allhandsactive/door-controller/docs/NodeMCUv3_Pinout.png

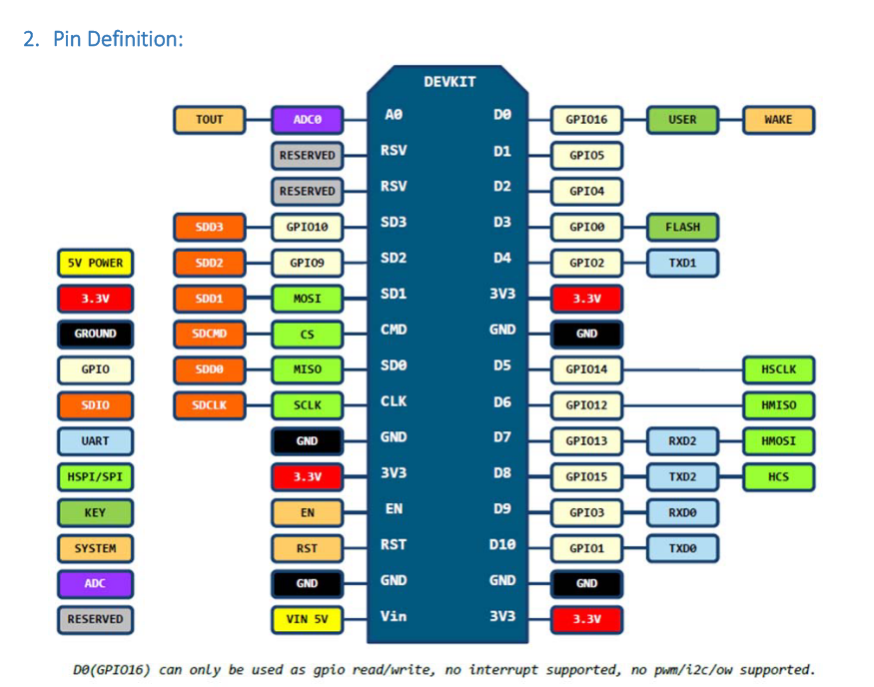
docs/NodeMCUv3_Pinout.png
