allhandsactive/door-controller/README.md

# door-controller
Code + PCB for ESP-based RFID card access door control
