allhandsactive/door-controller/pcb/pcb.kicad_pcb

## KiCad design pcb/pcb.kicad_pcb (2022-08-01)

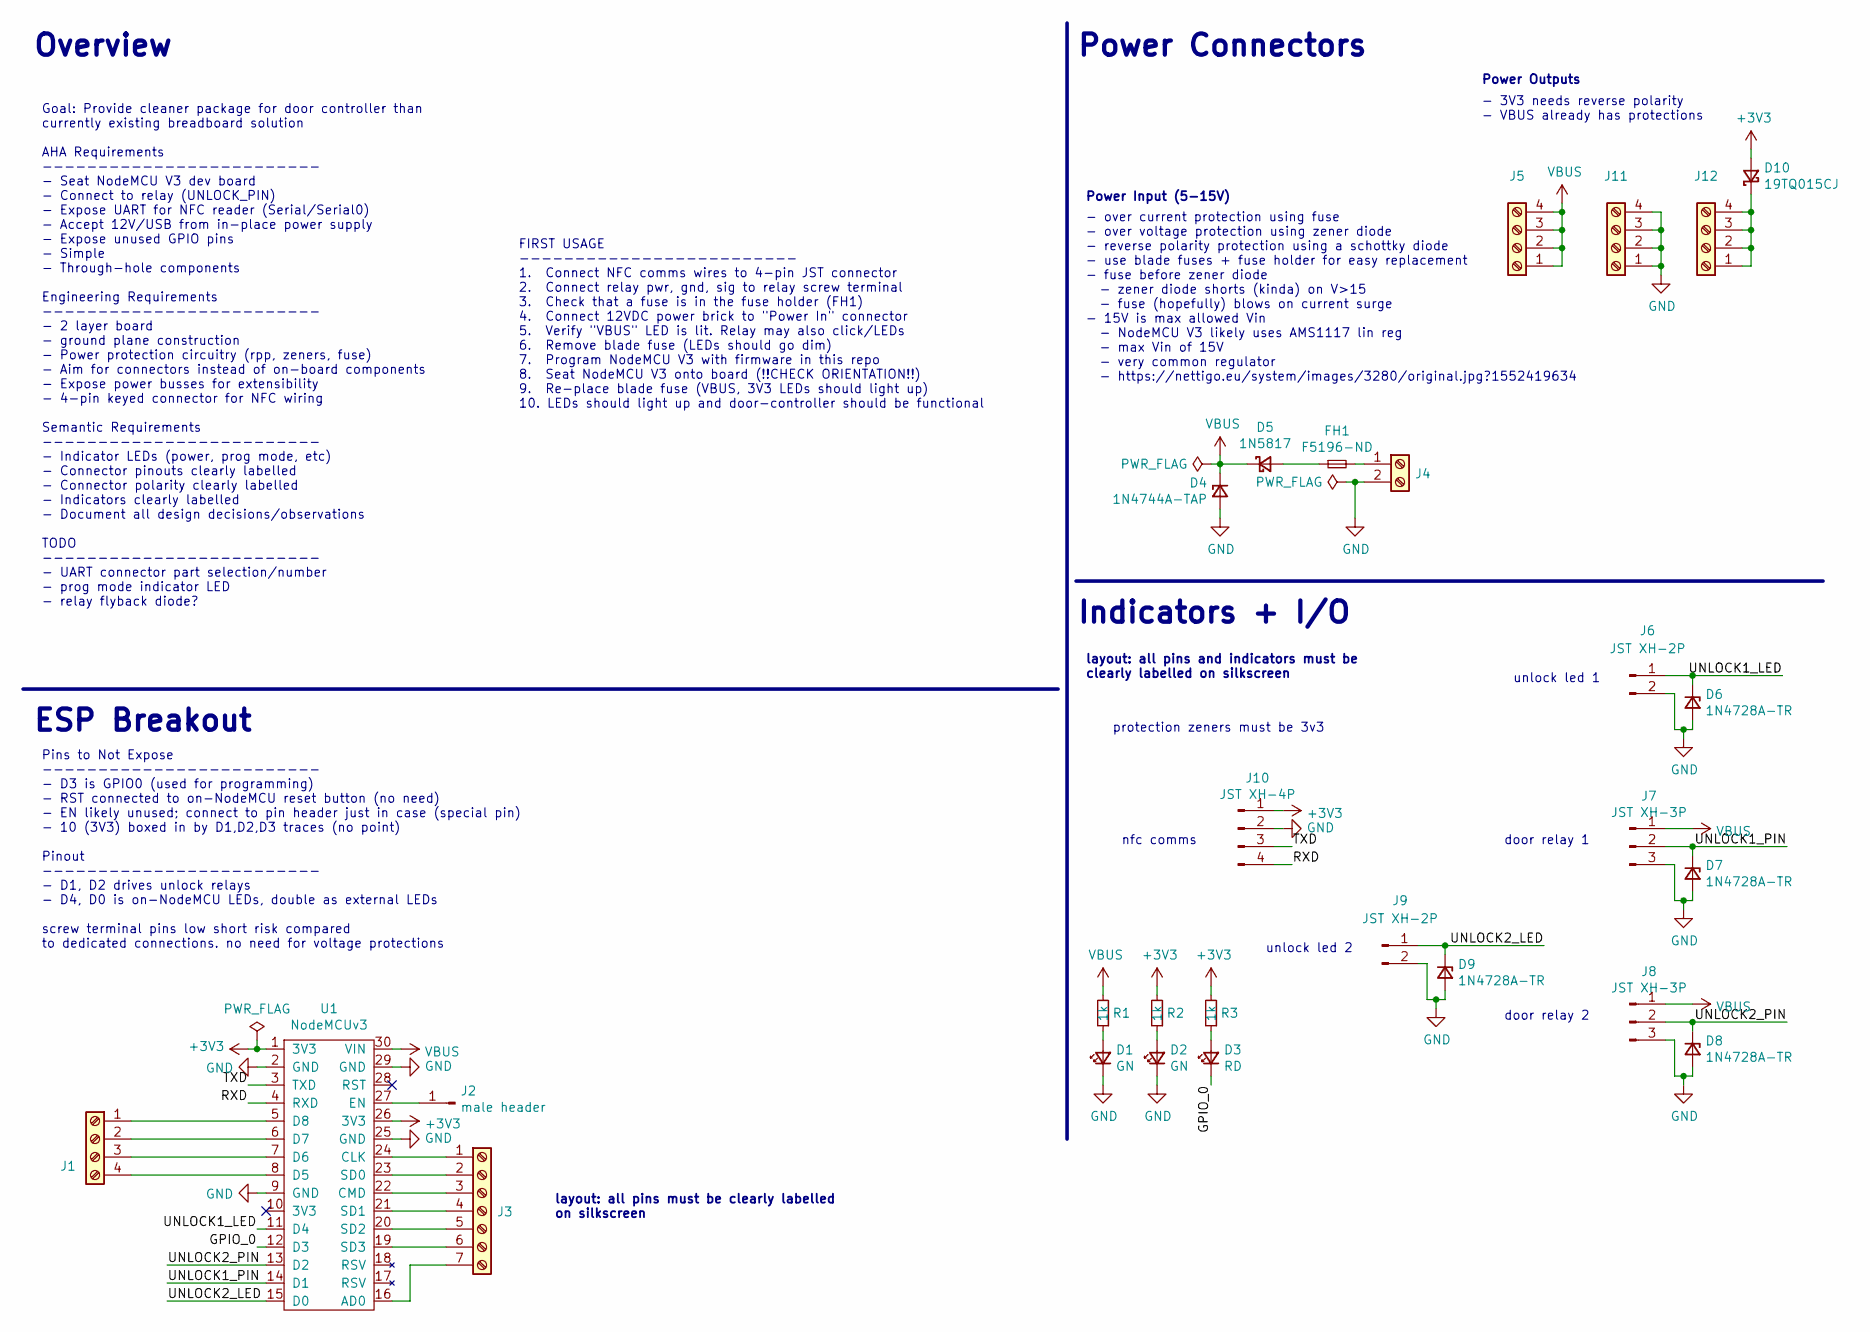
[picture p2: schematic pcb.kicad_sch, Door Controller]

Parts:
D1, D2: GN; LED_D5.0mm; PartNo LTL-4233; Digi-Key 160-1130-ND
D3: RD; LED_D5.0mm; PartNo LTL-4263; Digi-Key 160-1964-ND
D4: 1N4744A-TAP; D_DO-41_SOD81_P10.16mm_Horizontal; PartNo 1N4744A-TAP; Digi-Key 1N4744A-TAPGICT-ND
D5: 1N5817; D_DO-41_SOD81_P10.16mm_Horizontal; PartNo 1N5817-E3/54; Digi-Key 1N5817-E3/54GICT-ND
D6, D7, D8, D9: 1N4728A-TR; D_DO-41_SOD81_P10.16mm_Horizontal; PartNo 1N4728A-TR; Digi-Key 1N4728AVSCT-ND
D10: 19TQ015CJ; TO-220-2_Vertical; PartNo 19TQ015CJ; Digi-Key 1655-1005-ND
FH1: F5196-ND; Blade Fuse Holder; PartNo 178.6164.0002; Digi-Key F5196-ND
J1: Screw_Terminal_01x06; TerminalBlock_Phoenix_MPT-0,5-4-2.54_1x04_P2.54mm_Horizontal; PartNo 1725672; Digi-Key 277-1275-ND
J2: male header; PinHeader_1x01_P2.54mm_Vertical; PartNo 951101-8622-AR; Digi-Key 3M156413-01-ND
J3: Screw_Terminal_01x07; TerminalBlock_Phoenix_MPT-0,5-7-2.54_1x07_P2.54mm_Horizontal; PartNo 1725708; Digi-Key 277-1278-ND
J4: Screw_Terminal_01x02; TerminalBlock_Phoenix_MPT-0,5-2-2.54_1x02_P2.54mm_Horizontal; PartNo 1725656; Digi-Key 277-1273-ND
J5, J11, J12: Screw_Terminal_01x04; TerminalBlock_Phoenix_MPT-0,5-4-2.54_1x04_P2.54mm_Horizontal; PartNo 1725672; Digi-Key 277-1275-ND
J6, J9: JST XH-2P; JST_XH_B2B-XH-AM_1x02_P2.50mm_Vertical; PartNo B2B-XH-A-GU; Digi-Key 455-2946-ND
J7, J8: JST XH-3P; JST_XH_B3B-XH-AM_1x03_P2.50mm_Vertical; PartNo B3B-XH-AM(LF)(SN); Digi-Key 455-2231-ND
J10: JST XH-4P; JST_XH_B4B-XH-AM_1x04_P2.50mm_Vertical; PartNo B4B-XH-AM(LF)(SN); Digi-Key 455-2237-ND
R1, R2, R3: 1k; R_Axial_DIN0207_L6.3mm_D2.5mm_P10.16mm_Horizontal; PartNo CF14JT1K00; Digi-Key CF14JT1K00CT-ND
U1: NodeMCUv3

Connections:
+3V3: D10.2 (A), J10.1, R2.2, R3.2, U1.1 (3V3), U1.26 (3V3)
/GPIO_0: D3.1 (K), U1.12 (D3)
/RXD: J10.4, U1.4 (RXD)
/TXD: J10.3, U1.3 (TXD)
/UNLOCK1_LED: D6.1 (K), J6.1, U1.11 (D4)
/UNLOCK1_PIN: D7.1 (K), J7.2, U1.14 (D1)
/UNLOCK2_LED: D9.1 (K), J9.1, U1.15 (D0)
/UNLOCK2_PIN: D8.1 (K), J8.2, U1.13 (D2)
GND: D1.1 (K), D2.1 (K), D4.2 (A), D6.2 (A), D7.2 (A), D8.2 (A), D9.2 (A), J4.2, J6.2, J7.3, J8.3, J9.2, J10.2, J11.1, J11.2, J11.3, J11.4, U1.2 (GND), U1.9 (GND), U1.25 (GND), U1.29 (GND)
unnamed: D1.2 (A), R1.1
unnamed: D2.2 (A), R2.1
unnamed: D3.2 (A), R3.1
unnamed: D5.2 (A), FH1.1
unnamed: D10.1 (K), J12.1, J12.2, J12.3, J12.4
unnamed: FH1.2, J4.1
unnamed: J1.1, U1.5 (D8)
unnamed: J1.2, U1.6 (D7)
unnamed: J1.3, U1.7 (D6)
unnamed: J1.4, U1.8 (D5)
unnamed: J2.1, U1.27 (EN)
unnamed: J3.1, U1.24 (CLK)
unnamed: J3.2, U1.23 (SD0)
unnamed: J3.3, U1.22 (CMD)
unnamed: J3.4, U1.21 (SD1)
unnamed: J3.5, U1.20 (SD2)
unnamed: J3.6, U1.19 (SD3)
unnamed: J3.7, U1.16 (AD0)
VBUS: D4.1 (K), D5.1 (K), J5.1, J5.2, J5.3, J5.4, J7.1, J8.1, R1.2, U1.30 (VIN)

Notes on the sheet:
Power Outputs
Overview
Indicators + I/O
door relay 2
- 3V3 needs reverse polarity - VBUS already has protections
Power Connectors
layout: all pins must be clearly labelled on silkscreen
ESP Breakout
protection zeners must be 3v3
- over current protection using fuse - over voltage protection using zener diode - reverse polarity protection using a schottky diode - use blade fuses + fuse holder for easy replacement - fuse before zener diode - zener diode shorts (kinda) on V>15 - fuse (hopefully) blows on current surge - 15V i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
unlock led 2
unlock led 1
layout: all pins and indicators must be clearly labelled on silkscreen
Goal: Provide cleaner package for door controller than currently existing breadboard solution AHA Requirements ------------------------- - Seat NodeMCU V3 dev board - Connect to relay (UNLOCK_PIN) - Expose UART for NFC reader (Serial/Serial0) - Accept 12V/USB from in-place power supply - Expose unu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
door relay 1
Power Input (5-15V)
FIRST USAGE ------------------------- 1. Connect NFC comms wires to 4-pin JST connector 2. Connect relay pwr, gnd, sig to relay screw terminal 3. Check that a fuse is in the fuse holder (FH1) 4. Connect 12VDC power brick to "Power In" connector 5. Verify "VBUS" LED is lit. Relay may also click/LEDs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
nfc comms
Pins to Not Expose ------------------------- - D3 is GPIO0 (used for programming) - RST connected to on-NodeMCU reset button (no need) - EN likely unused; connect to pin header just in case (special pin) - 10 (3V3) boxed in by D1,D2,D3 traces (no point) Pinout ------------------------- - D1, D2 dri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

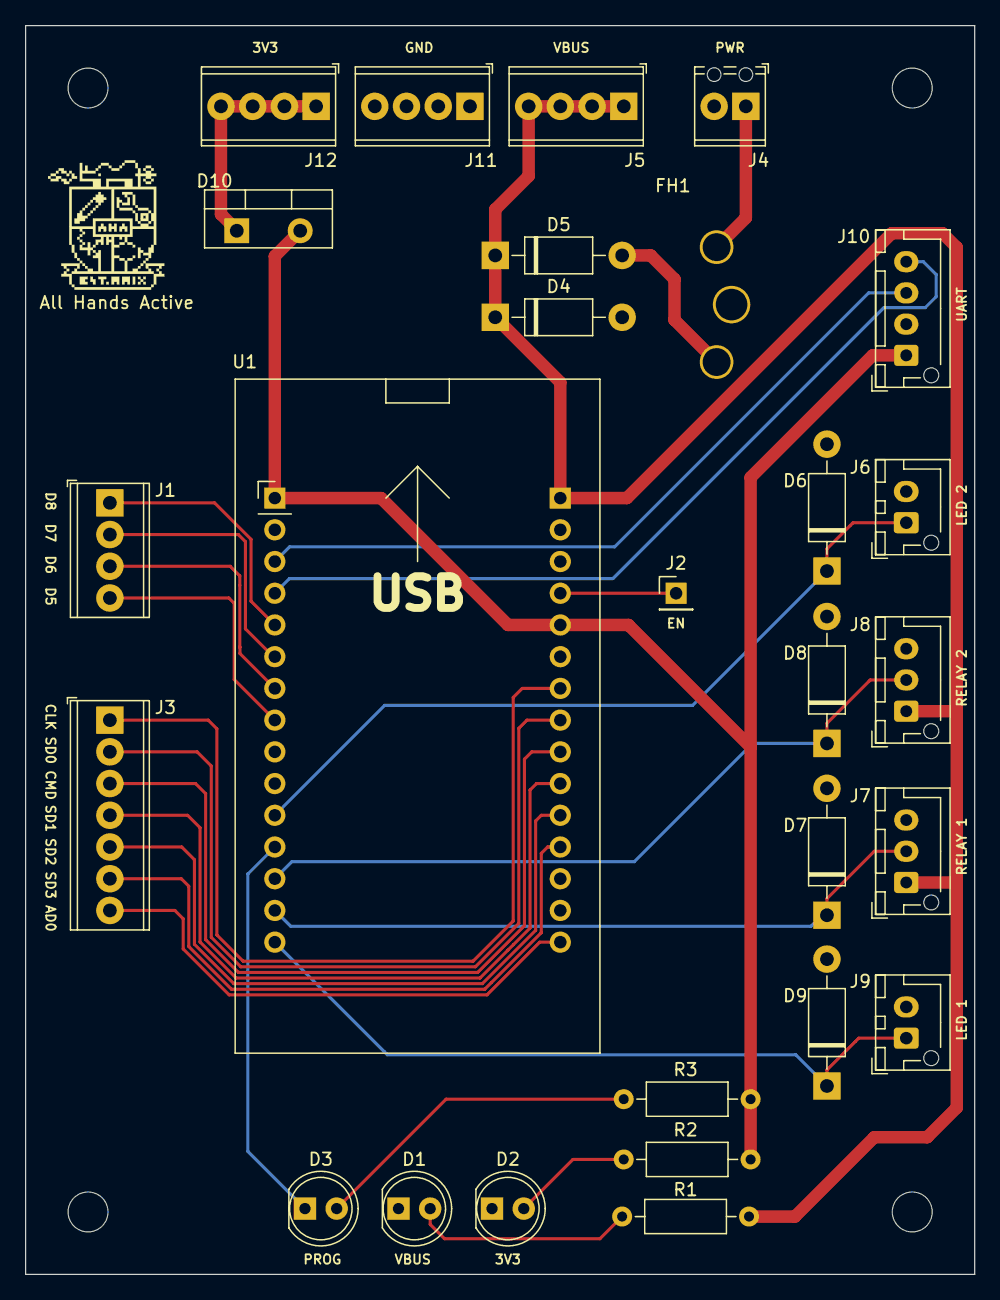
[picture p3: board pcb.kicad_pcb from above]

Board: 2 copper layers, 76.0 x 100.0 mm, 31 parts (0 on the bottom side), 28 nets.

Other parts of the board:
H1, H2, H3, H4: MountingHole_3.2mm_M3
