allhandsactive/door-controller/(commit log)

2020-07-26 Updated door access code to reflect newer OS (Raspberry Pi OS) and NFC Python lib (nfcpy). Cleaned up a few other code things as well.
2022-04-16 initial ESP daughter board work - pinout + sym + fp
    [pcb.kicad_pcb, pcb.sch]
2022-05-01 pcb pinout + protections
    [pcb.sch]
2022-05-01 added esp board datasheet to sch symbol
    [pcb.sch]
2022-05-01 updated esp board symbol name to its common name
    [pcb.sch]
2022-05-01 major schematic reorg+documentation
    [pcb.sch]
2022-05-03 UNLOCK_PIN change and connector selection for relay
    [pcb.sch]
2022-05-07 1n4148->1n4004 and connector changes
    [pcb.sch]
2022-05-07 schematic pinout edits + documentation
    [pcb.sch]
2022-05-07 ERC fixes - pwr_flags + nodemcuv3 power pins
    [pcb.sch]
2022-05-07 all-but-zener footprint assignment
    [pcb.sch]
2022-05-07 zener selection + footprint assignment
    [pcb.sch]
2022-05-07 footprint rename: lolinv3->NodeMCUv3
    [pcb.sch]
2022-07-29 Update to Kicad 6
    [pcb.kicad_pcb, pcb.kicad_sch, pcb.sch]
2022-07-31 Update schematic with part numbers for BOM
    [pcb.kicad_sch]
2022-07-31 Layout components on PCB Board
    [pcb.kicad_pcb]
2022-07-31 Route door controller pcb
    [pcb.kicad_pcb, pcb.kicad_sch]
2022-08-01 Added second relay and LED connectors to the PCB to allow controlling of two doors
    [pcb.kicad_pcb, pcb.kicad_sch]
